ruuvi/business-card/business-card-a1/export/README.TXT

Board: Business Card Rev.A1

Board Size: 		85.6x54mm
Material: 		FR4
Layers: 		2
Silkscreen: 		Matte black, top & bottom
Solder masks: 		White, top & bottom
Plating: 		Immersion Gold
Total thickness: 	0.5mm

Minimum clearance: 	0.2mm
Minimum trace width: 	0.2mm
Minimum hole diameter:	0.3mm

Layer files (in correct order):
 
1. F.Cu (top)
2. B.Cu (bottom)
       
Technical contact:

	Lauri Jämsä
	lauri@ruuvi.com
