ruuvi/business-card/business-card-a1/export/2d-bot.png

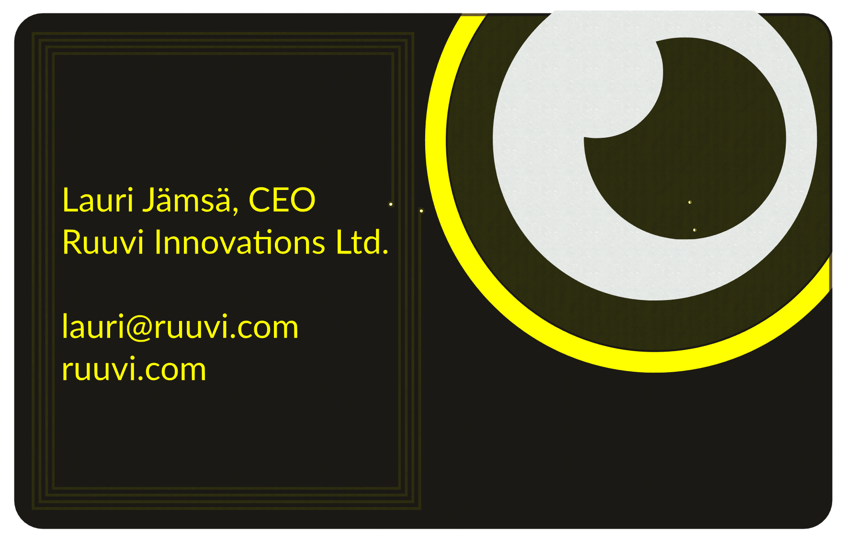
business-card-a1/export/2d-bot.png
