ruuvi/business-card/business-card-a1/export/2d-top.png

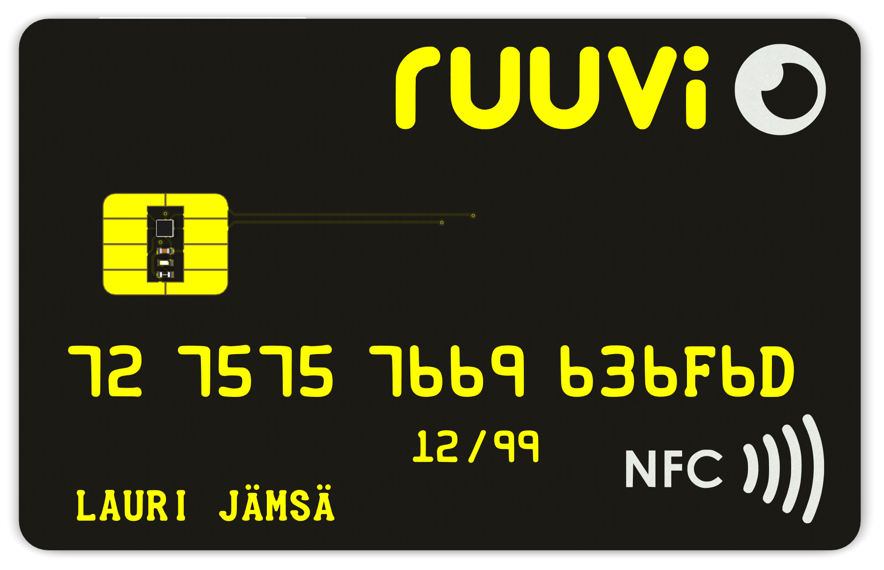
business-card-a1/export/2d-top.png
