ruuvi/business-card/business-card-a1/export/3d-bot.png

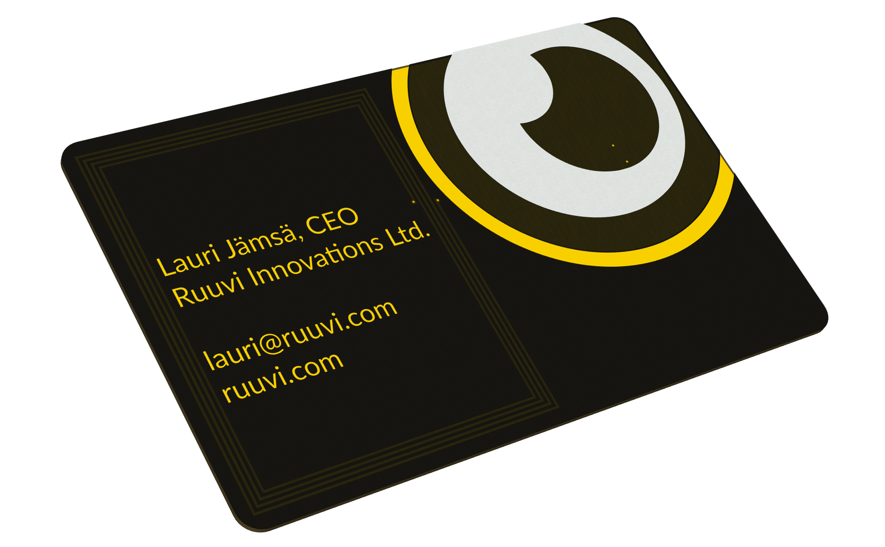
business-card-a1/export/3d-bot.png
