ruuvi/business-card/business-card-a1/export/3d-top.png

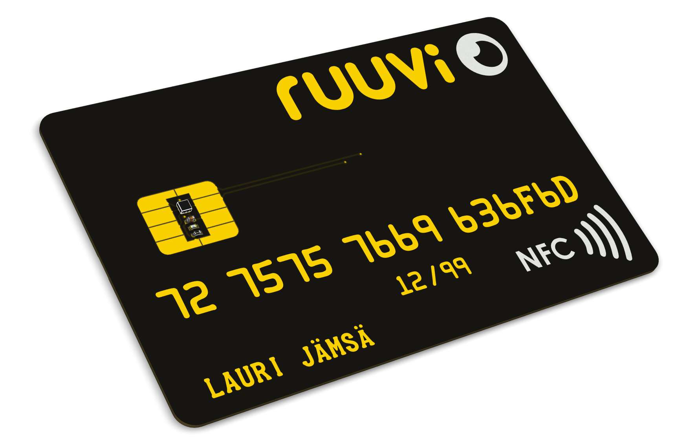
business-card-a1/export/3d-top.png
