ruuvi/business-card/business-card-a1/export/dimensions.png

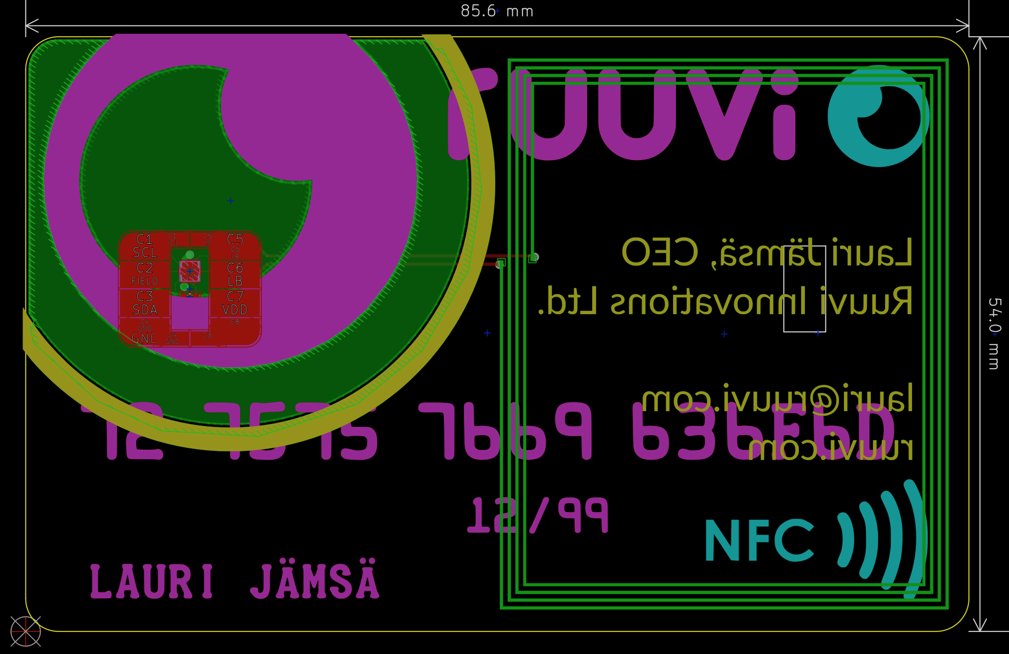
business-card-a1/export/dimensions.png
