ruuvi/business-card/business-card-a1/i/bot-copper-cutted.png

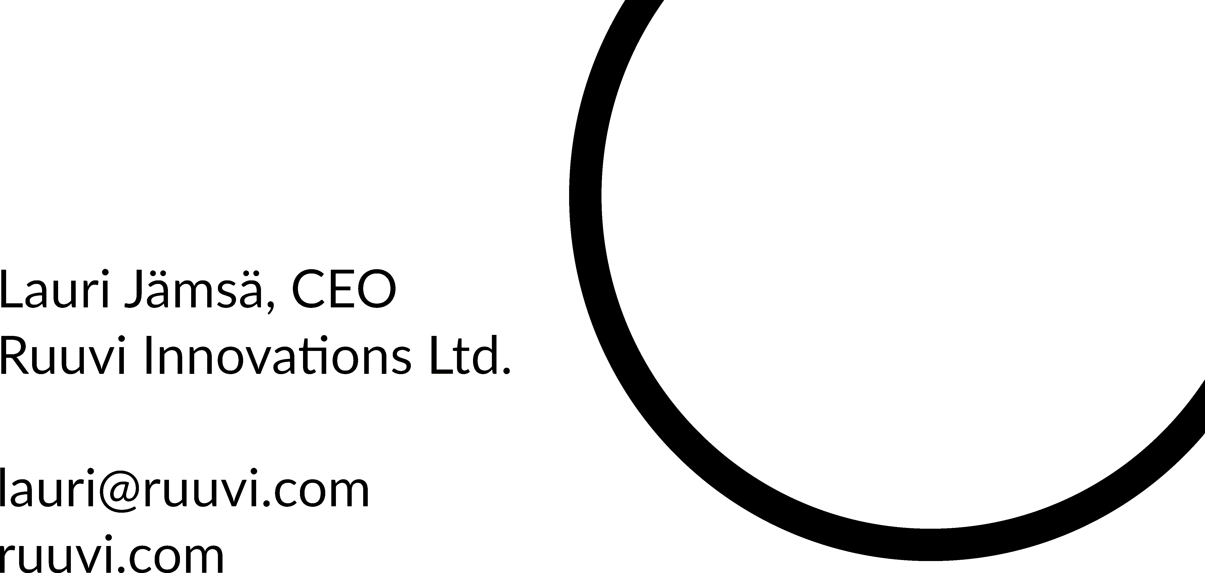
business-card-a1/i/bot-copper-cutted.png
