ruuvi/business-card/business-card-a1/i/bot-silk.png

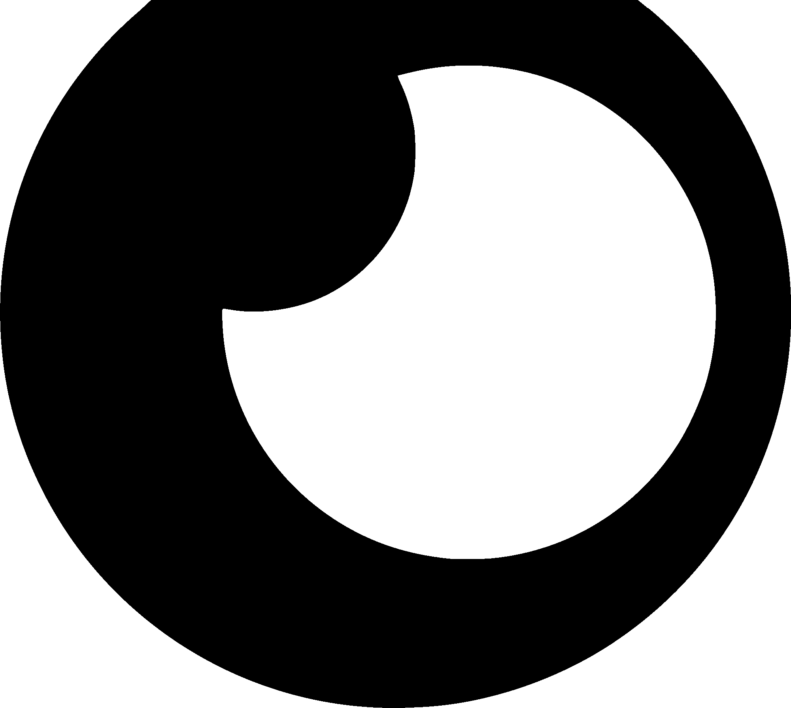
business-card-a1/i/bot-silk.png
