ruuvi/business-card/business-card-a1/i/bottom.png

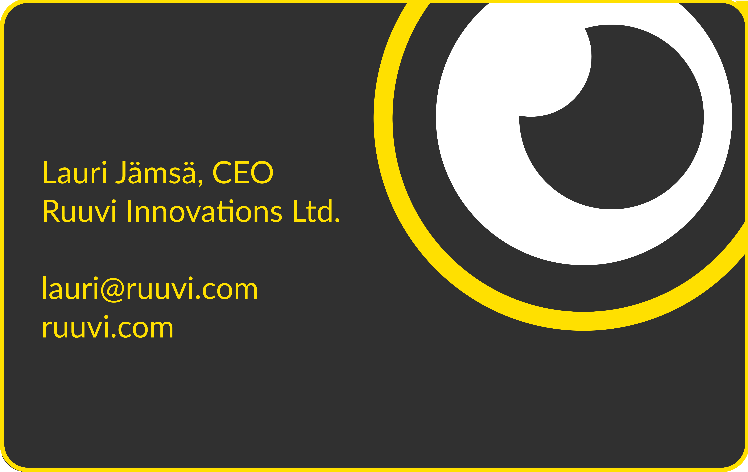
business-card-a1/i/bottom.png
