ruuvi/business-card/business-card-a1/i/top-silk.png

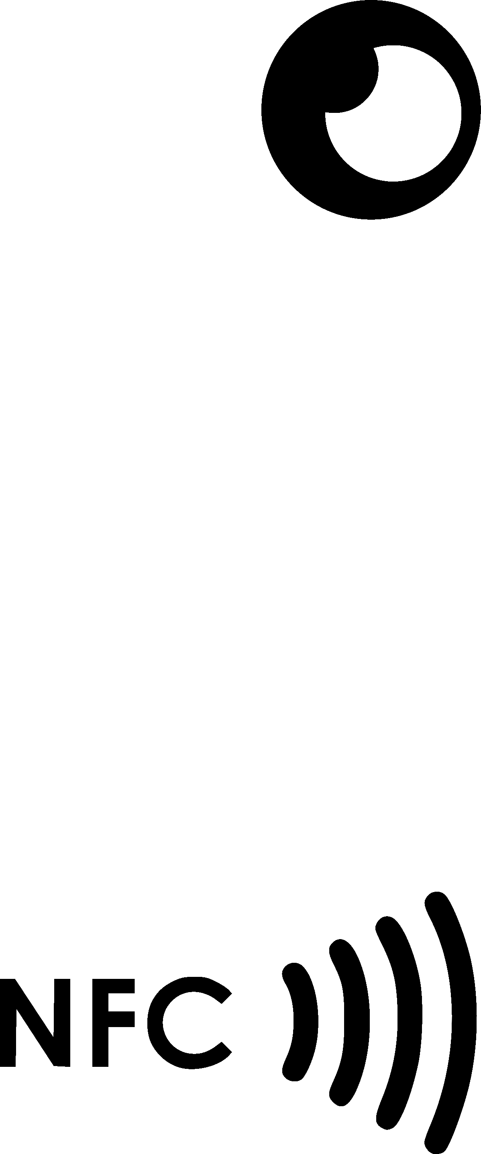
business-card-a1/i/top-silk.png
