ruuvi/business-card/business-card-a1/i/top.png

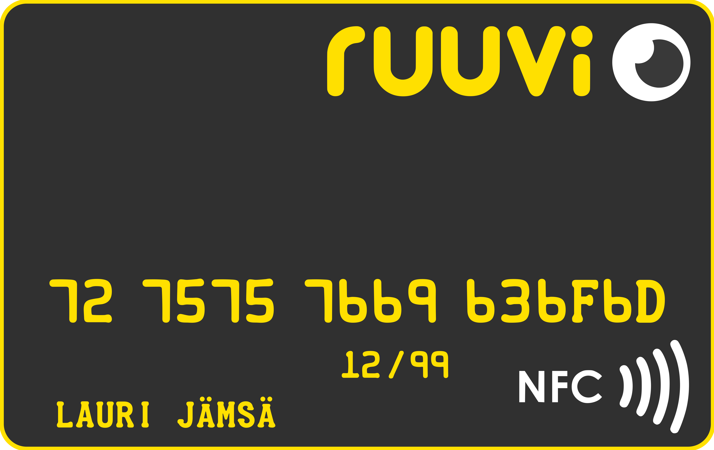
business-card-a1/i/top.png
