ruuvi/business-card/business-card-a1/i/top_copper.png

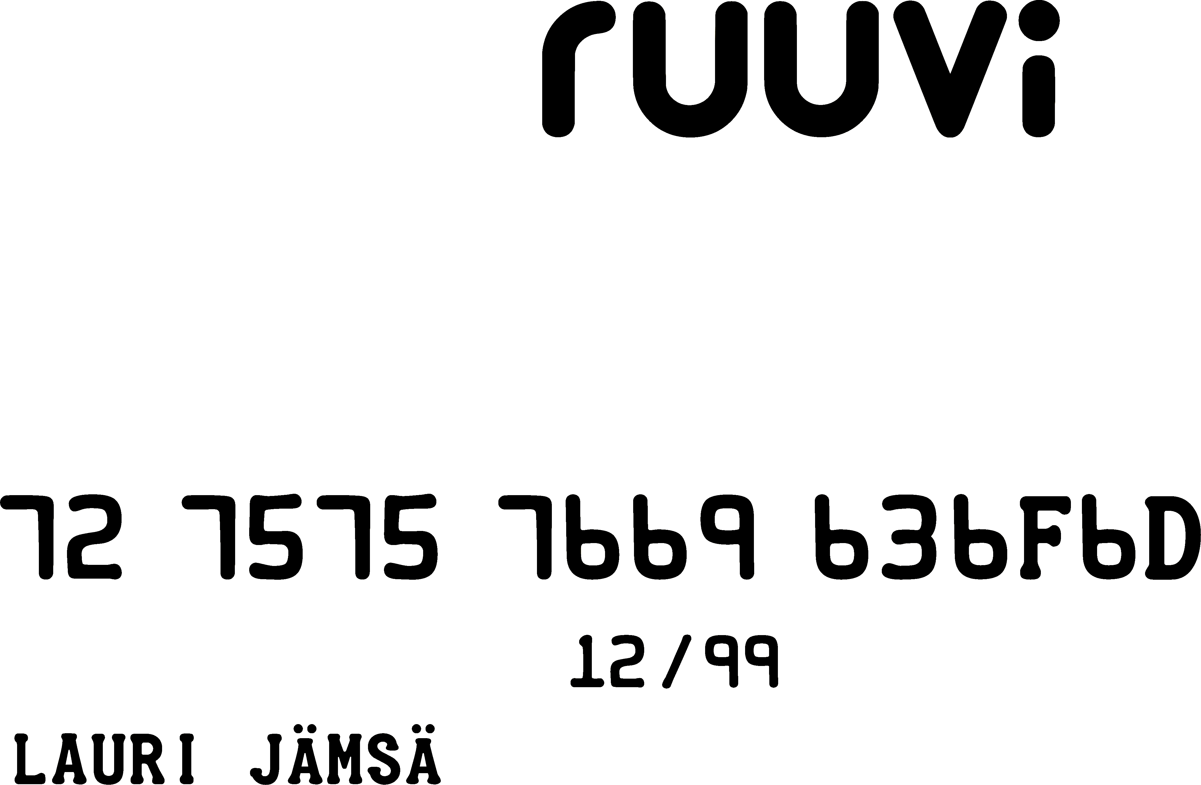
business-card-a1/i/top_copper.png
