ruuvi/business-card/business-card-a1/nfc-antenna/nfc-antenna-edesignsuite.png

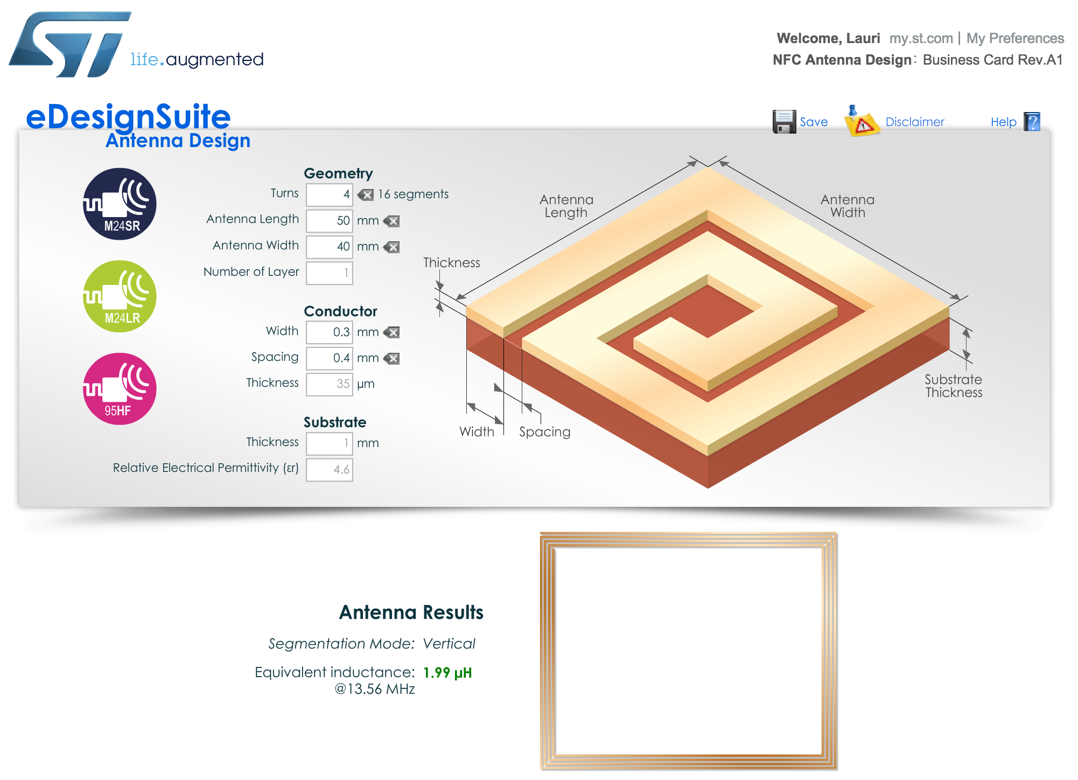
business-card-a1/nfc-antenna/nfc-antenna-edesignsuite.png
