ruuvi/business-card/business-card-a1/nfc-antenna/nfc-antenna-export-new.png

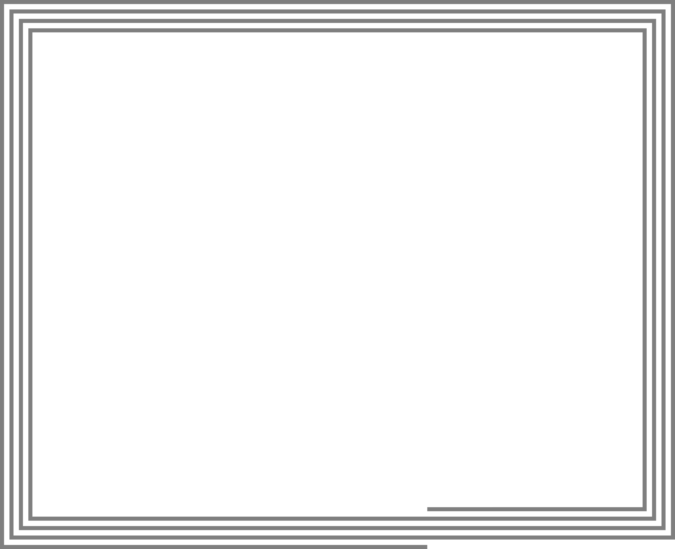
business-card-a1/nfc-antenna/nfc-antenna-export-new.png
