ruuvi/business-card/business-card-a1/export/3d-components.png

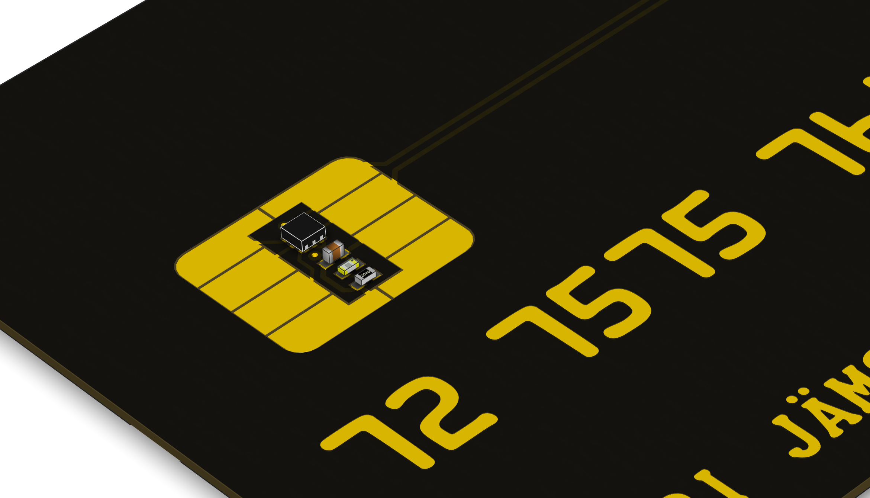
business-card-a1/export/3d-components.png
