ruuvi/business-card/business-card-a1/export/business-card-a1-schematic.pdf

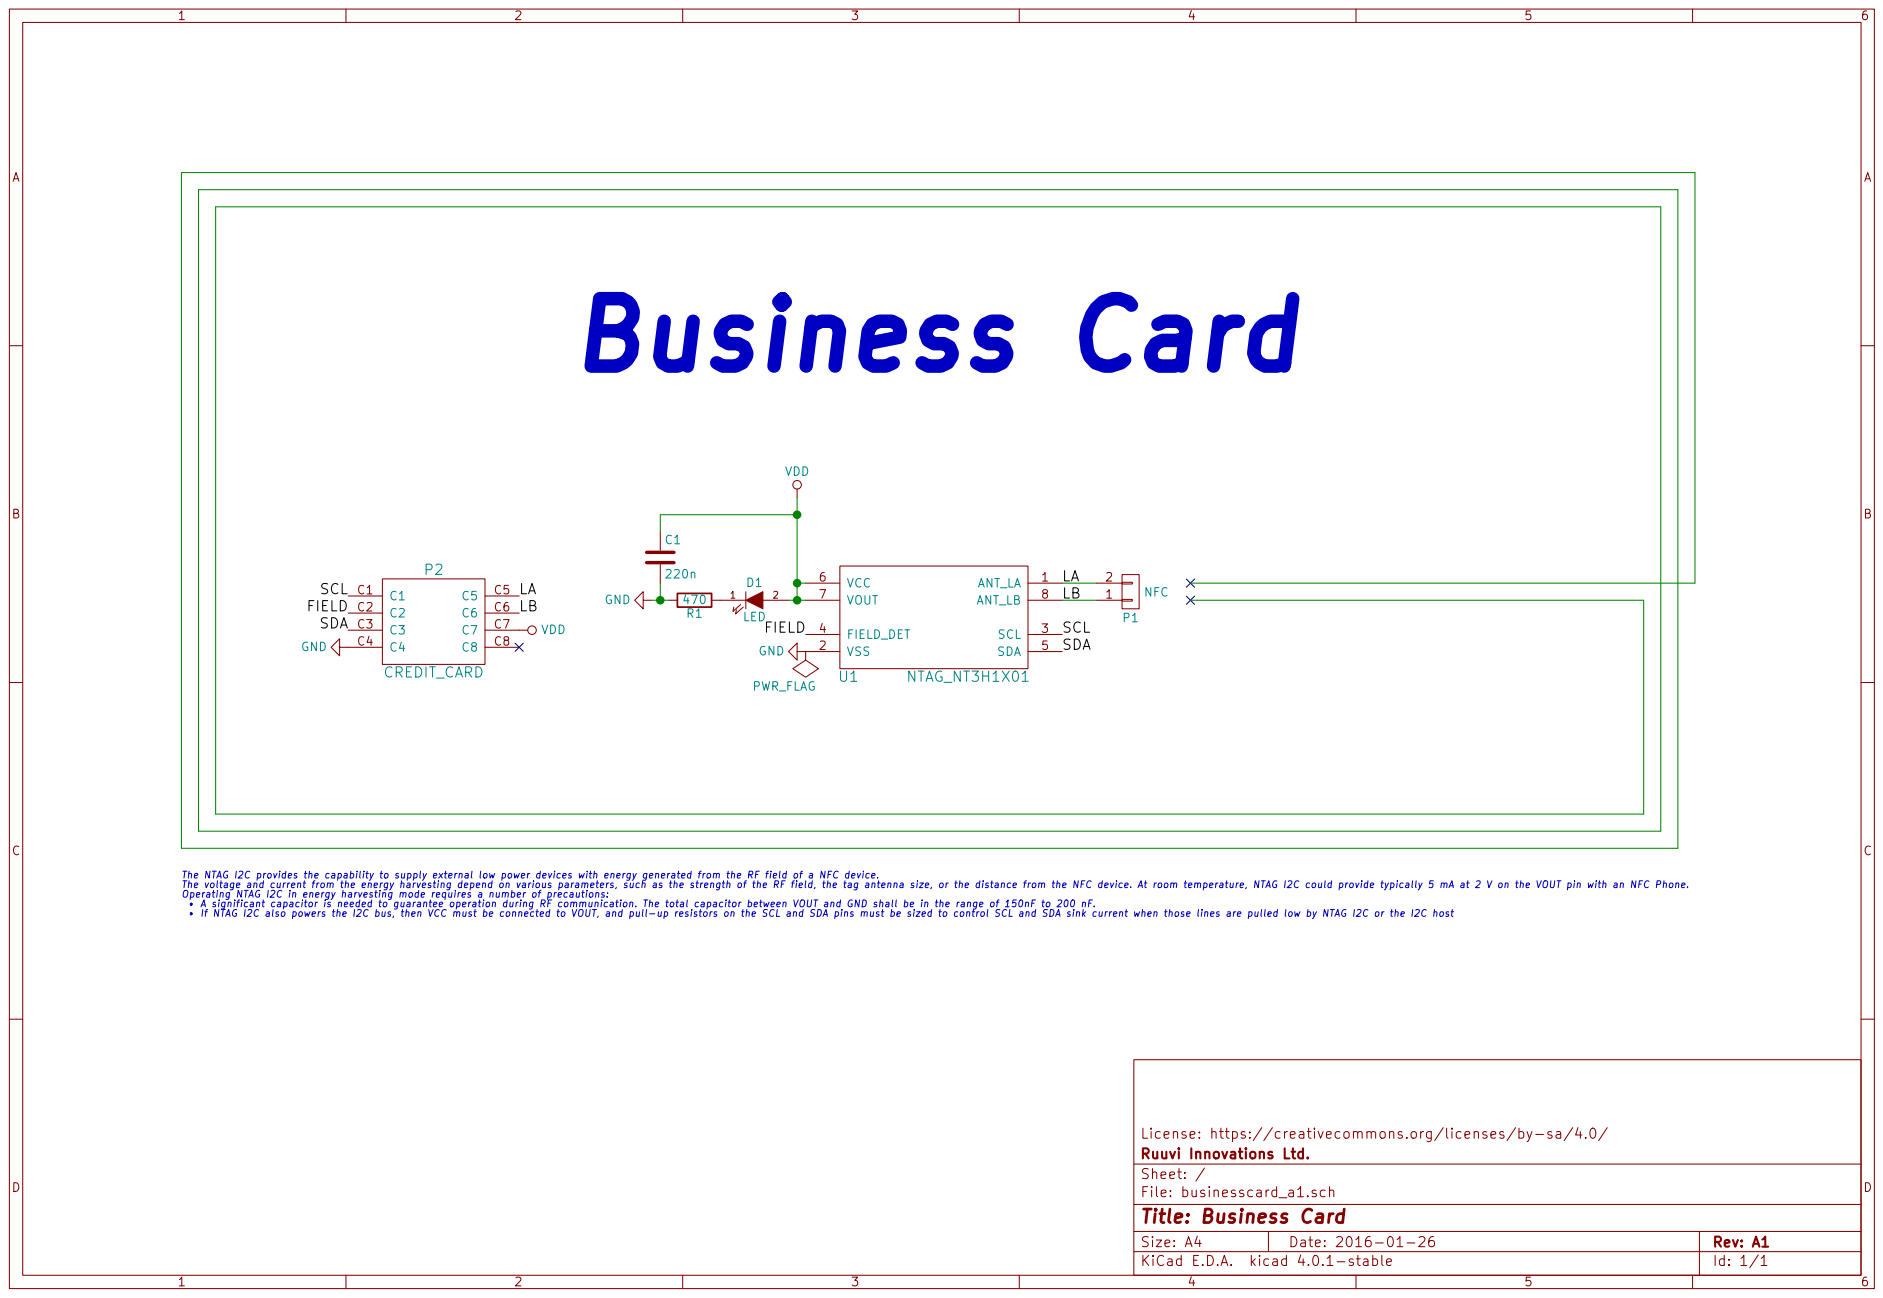
[picture p15: page 1]

LEDGND GND Business Card

The NTAG I2C provides the capability to supply external low power devices with energy generated from the RF field of a NFC device. The voltage and current from the energy harvesting depend on various parameters, such as the strength of the RF field, the tag antenna size, or the distance from the NFC device. At room temperature, NTAG I2C could provide typically 5 mA at 2 V on the VOUT pin with an NFC Phone. Operating NTAG I2C in energy harvesting mode requires a number of precautions:

A significant capacitor is needed to guarantee operation during RF communication. The total capacitor between VOUT and GND shall be in the range of 150nF to 200 nF.

Id: 1/1 Title: Business Card
