ruuvi/business-card/business-card-a1/export/business-card-a1-assembly/business-card-a1-assembly.pdf

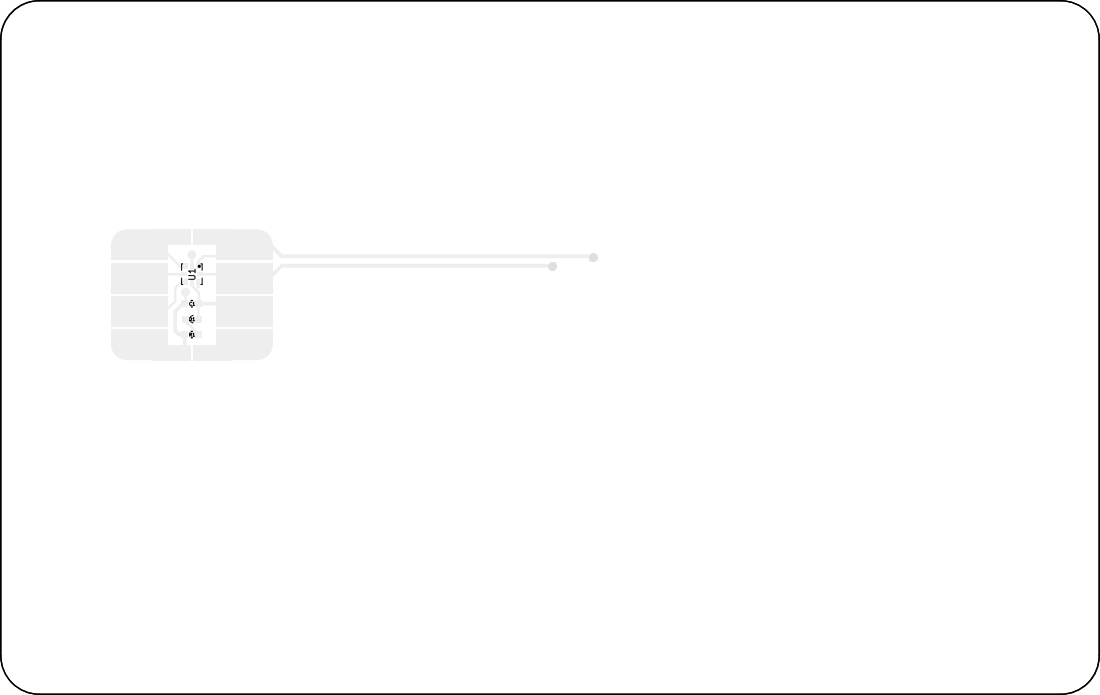
[picture p16: page 1]
