ruuvi/business-card/business-card-a1/i/business-card-company.pdf

72 7575 7669 63

12 99 /

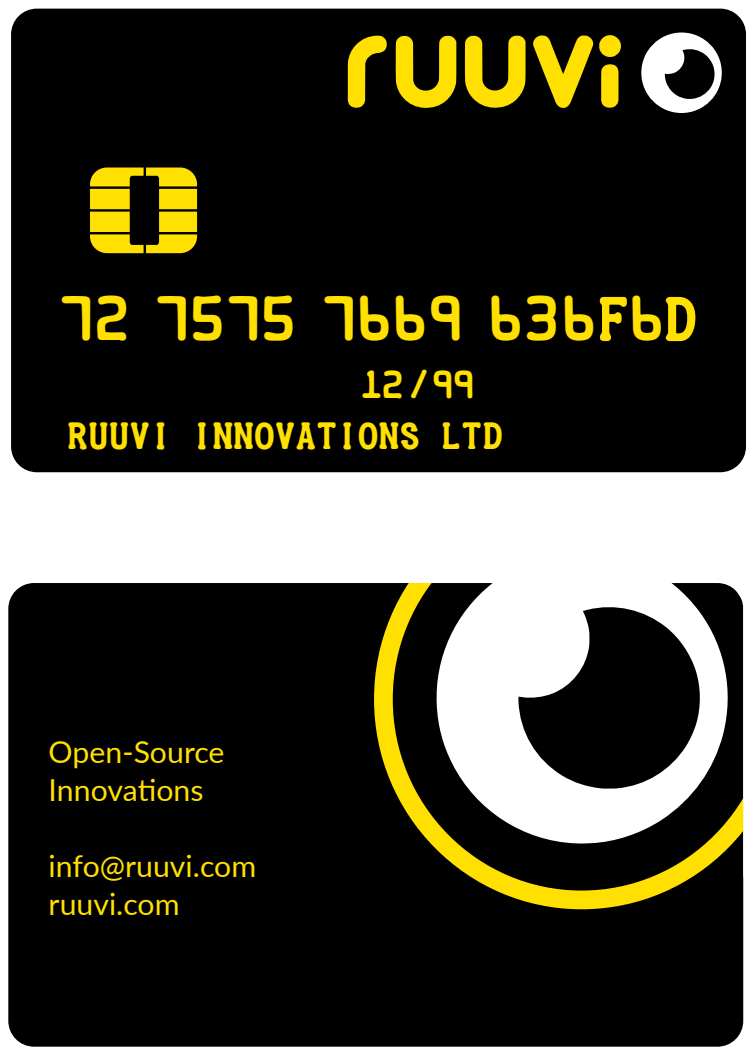
[picture p17: page 1]
Open-Source Innovaons

RUUVI INNOVATIONS LTD

info@ruuvi.com
ruuvi.com

Something totally new and innovative.

Hi there! This is us.
