ruuvi/business-card/business-card-a1/business-card-a1.kicad_pcb

## KiCad design business-card-a1/business-card-a1.kicad_pcb (2017-02-13)

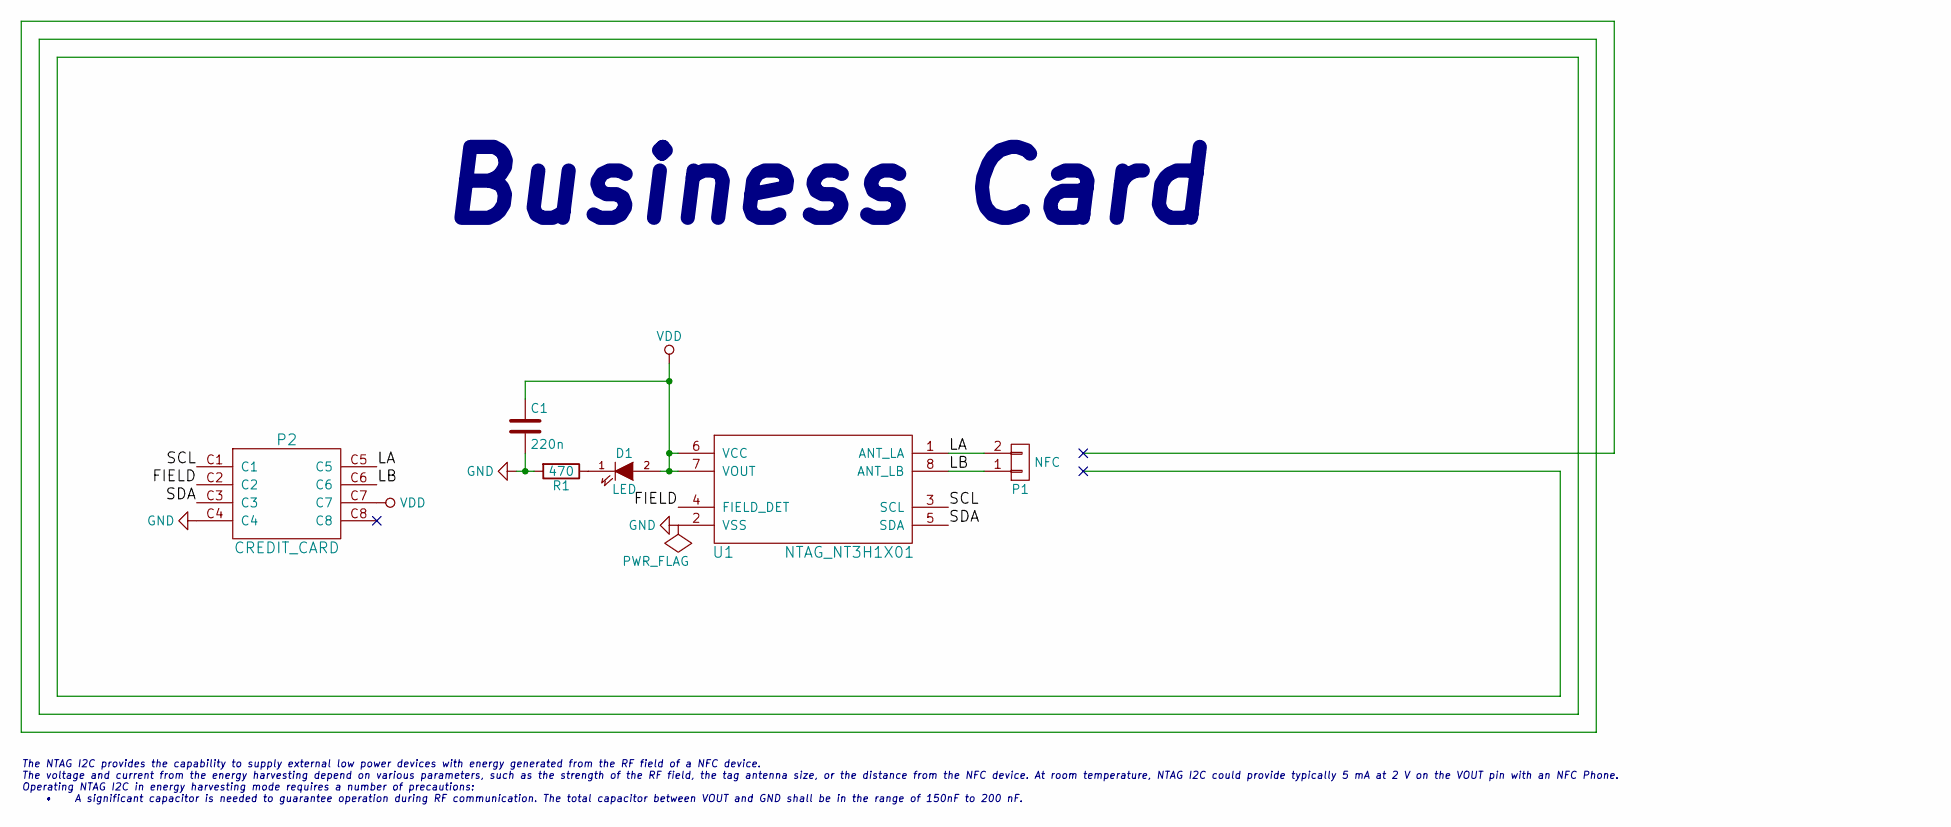
[picture p18: schematic business-card-a1.sch, Business Card]

Parts:
C1: 220n; 0402_CAP
D1: LED; 0402_LED
P1: NFC; BUSINESS_NFC_ANTENNA_4X5CM_NEW
P2: CREDIT_CARD; CREDIT_CARD_CHIP_EMPTY
R1: 470; 0402_RES
U1: NTAG_NT3H1X01; SOT902-3

Connections:
/FIELD: P2.C2, U1.4 (FIELD_DET)
/LA: P1.2, P2.C5, U1.1 (ANT_LA)
/LB: P1.1, P2.C6, U1.8 (ANT_LB)
/SCL: P2.C1, U1.3 (SCL)
/SDA: P2.C3, U1.5 (SDA)
GND: C1.2, P2.C4, R1.2, U1.2 (VSS)
unnamed: D1.1 (K), R1.1
VDD: C1.1, D1.2 (A), P2.C7, U1.6 (VCC), U1.7 (VOUT)

Notes on the sheet:
Business Card
The NTAG I2C provides the capability to supply external low power devices with energy generated from the RF field of a NFC device. The voltage and current from the energy harvesting depend on various parameters, such as the strength of the RF field, the tag antenna size, or the distance from the NF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

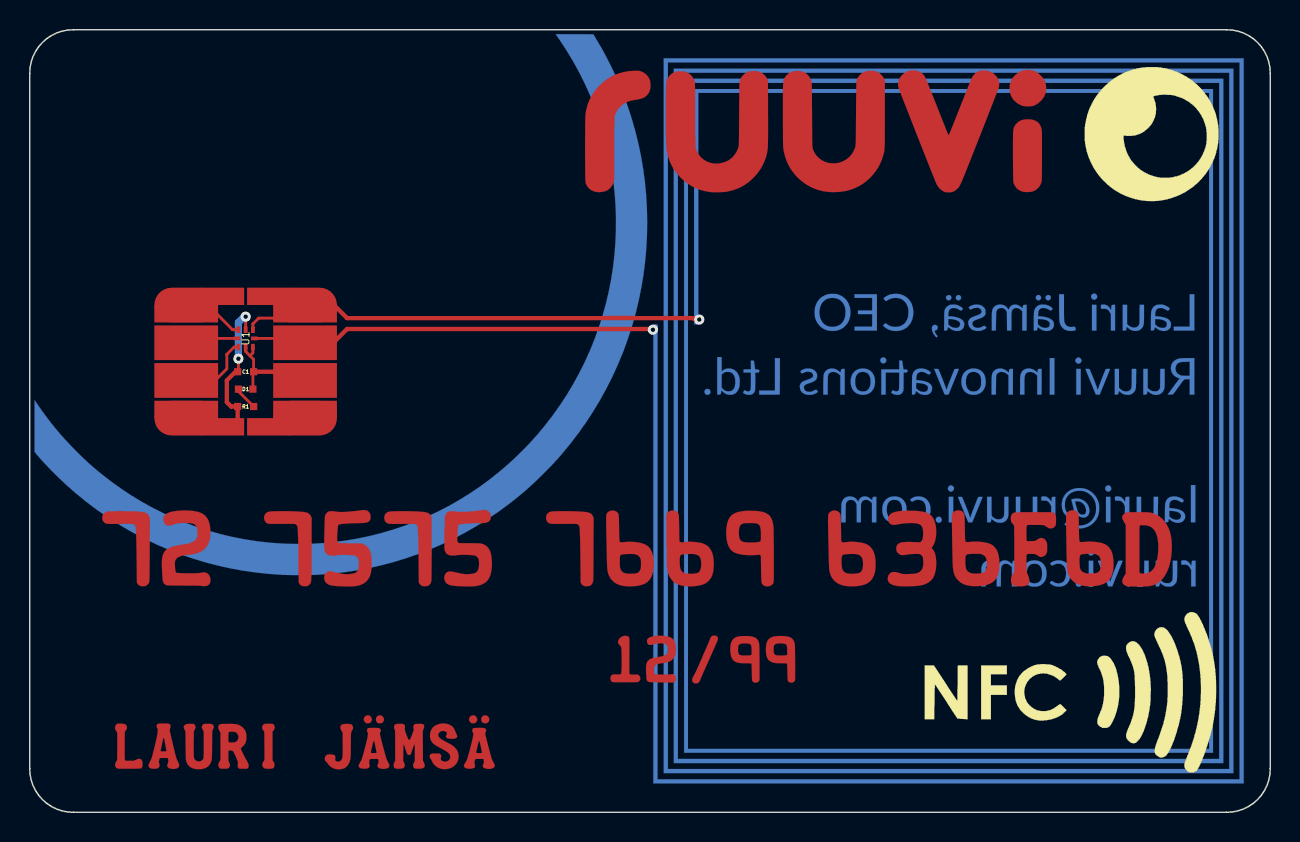
[picture p19: board business-card-a1.kicad_pcb from above]

Board: 2 copper layers, 85.6 x 54.0 mm, 6 parts (1 on the bottom side), 8 nets.
