ruuvi/business-card/(notices)

Notices in the files:
business-card-a1/business-card-a1.sch:
License: https://creativecommons.org/licenses/by-sa/4.0
